3dpractical/fcoDetector/IMG_0498.JPG

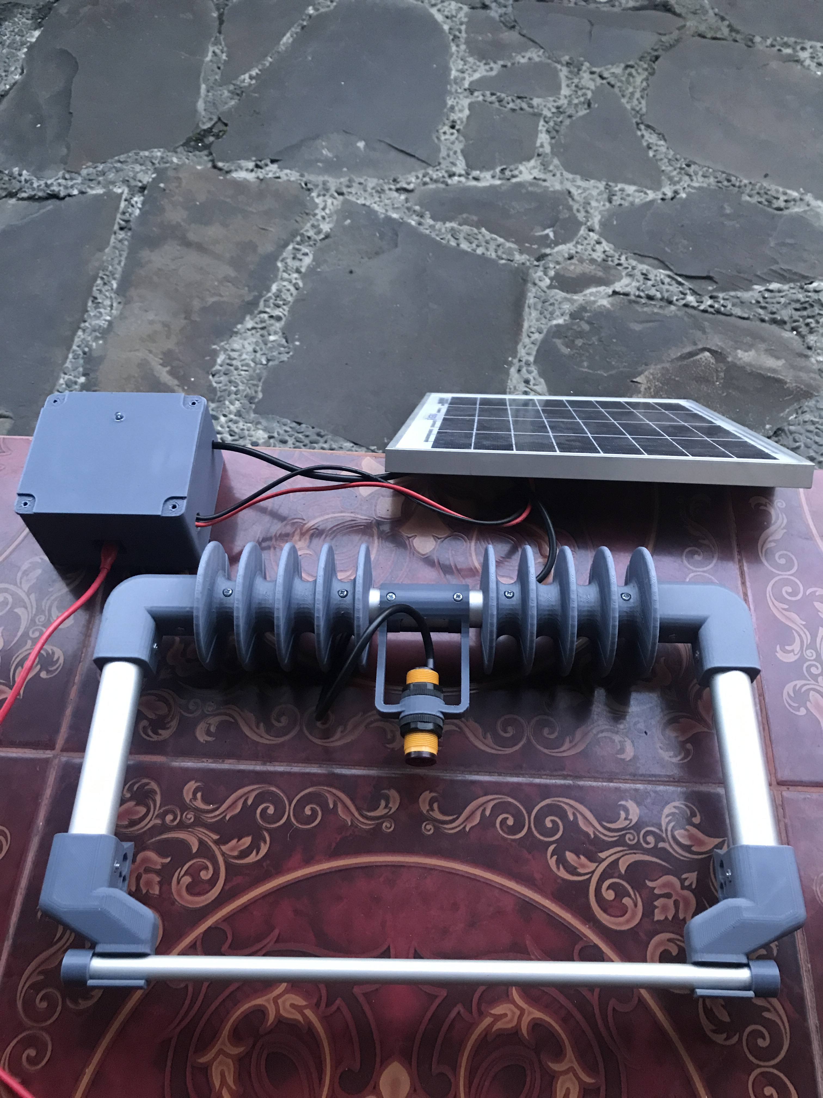
IMG_0498.JPG
