3dpractical/fcoDetector/Electrical Design/FCO_Detector R1/FCO_Detector/board.png

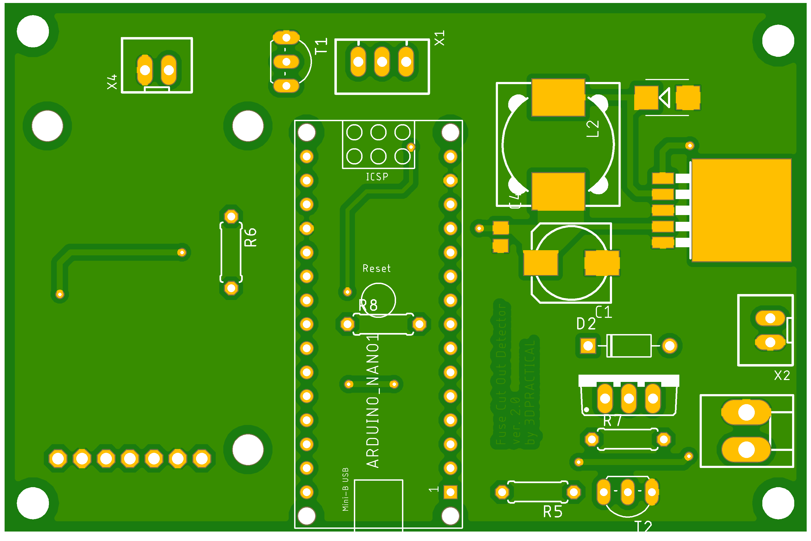
Electrical Design/FCO_Detector R1/FCO_Detector/board.png
