3dpractical/fcoDetector/FCO - Schematic.png

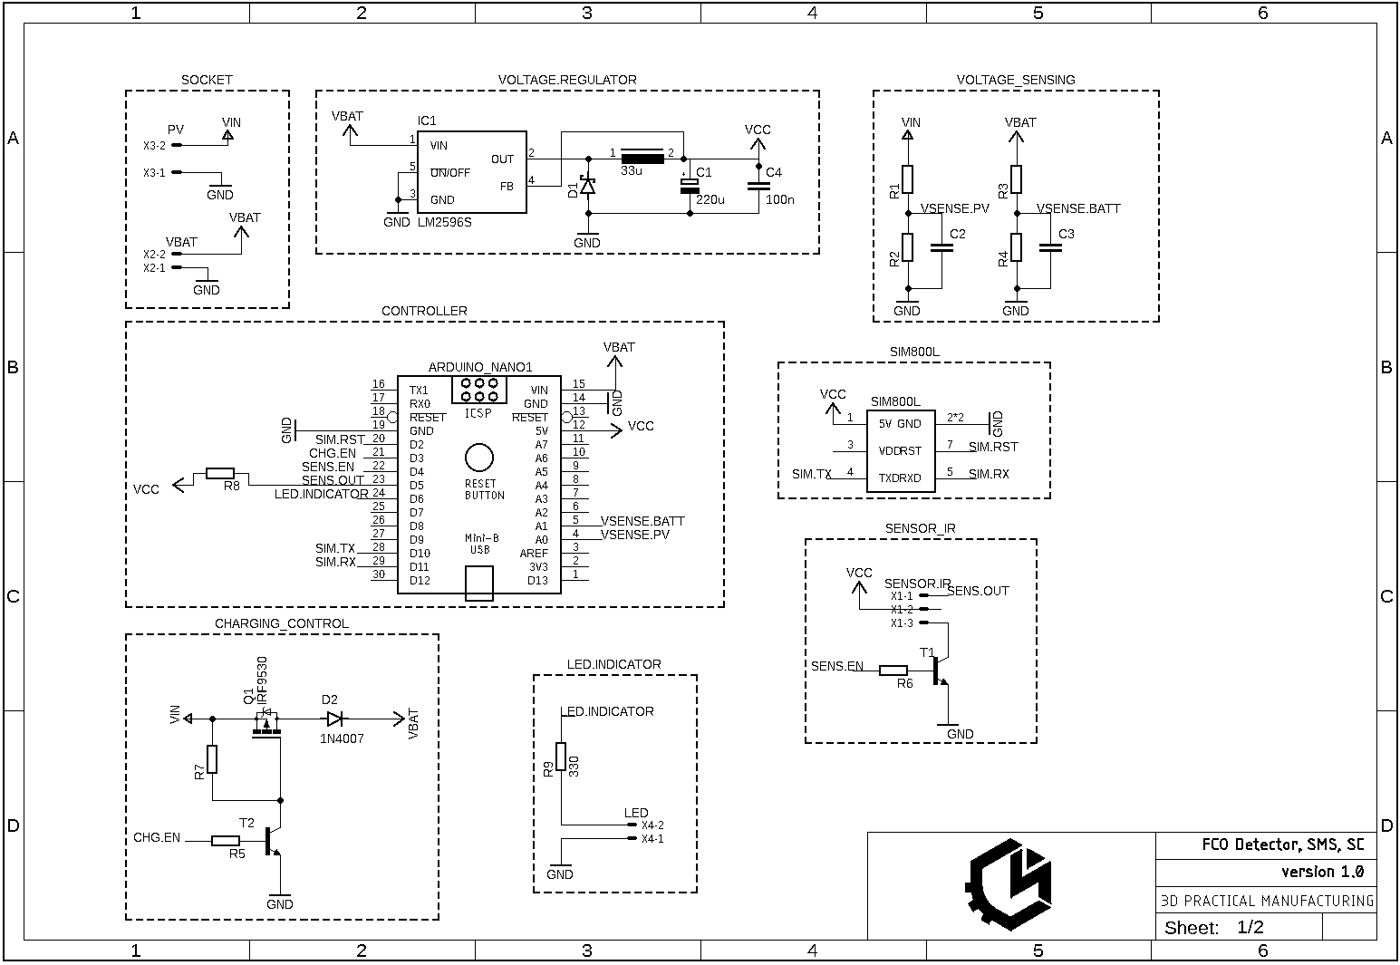
FCO - Schematic.png
