3dpractical/fcoDetector/Schematic Diagram.png

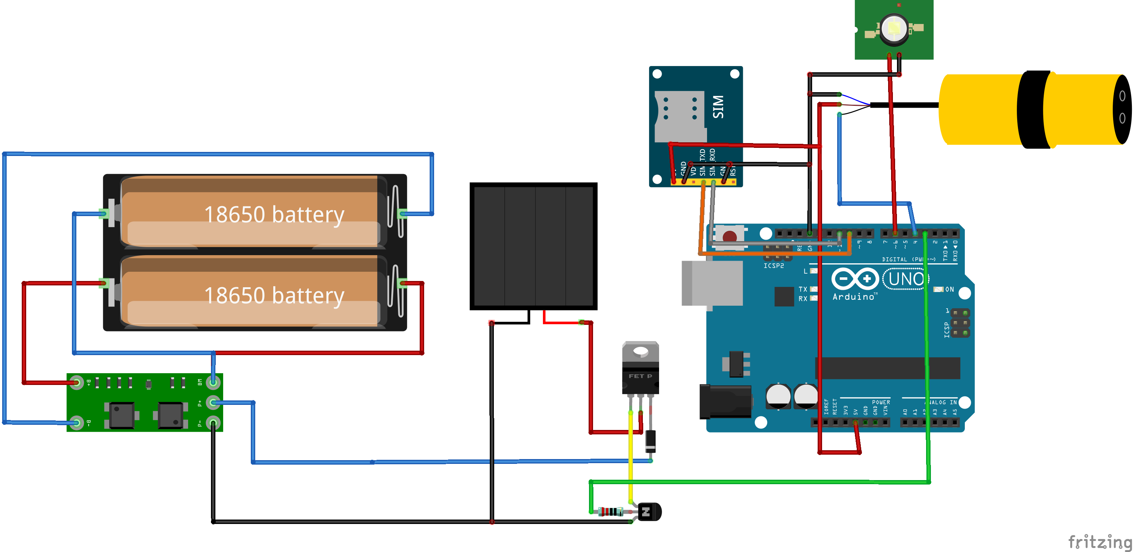
Schematic Diagram.png
