3dpractical/fcoDetector/Single Line Diagram/PWM SCC - FCO DETECTOR.jpg

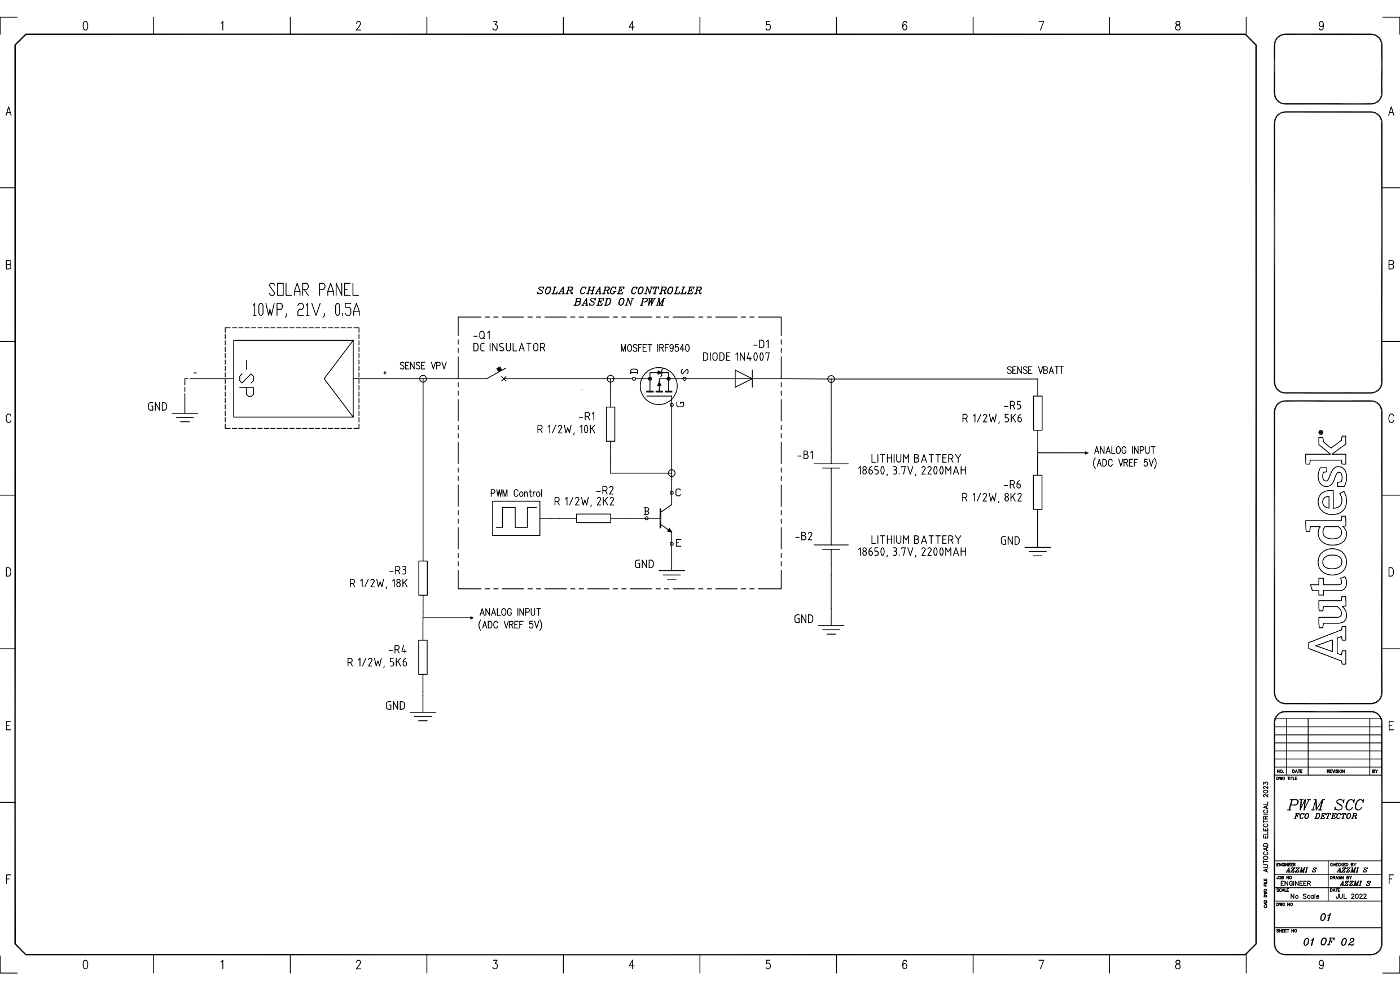
Single Line Diagram/PWM SCC - FCO DETECTOR.jpg
