3dpractical/fcoDetector/Mechanical Design/[3D Sketch] FCO detector/Assembly FCO Detector.SLDASM

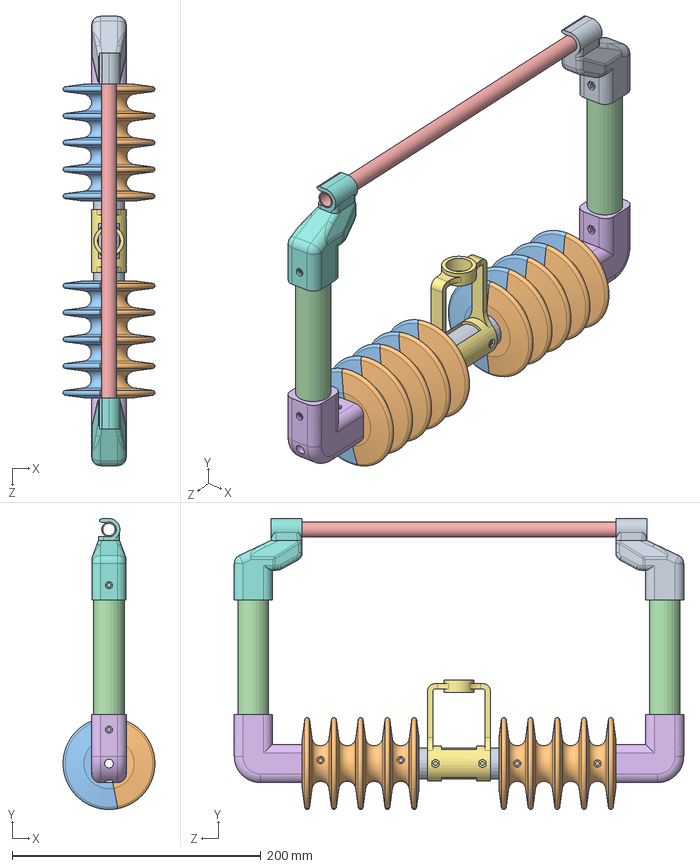
[picture p8: CAD file, 2022-10-04]
Mechanical Design/[3D Sketch] FCO detector/Assembly FCO Detector.SLDASM
73.8 x 233.8 x 361.2 mm
frame isolator
isolator atas x 2
isolator bawah x 2
frame sambungam x 2
fuse
terminal x 2
mount sensor
terminal fuse atas 2
terminal fuse atas
