3dpractical/fcoDetector/Mechanical Design/[3D Sketch] FCO detector/frame sambungam.SLDPRT

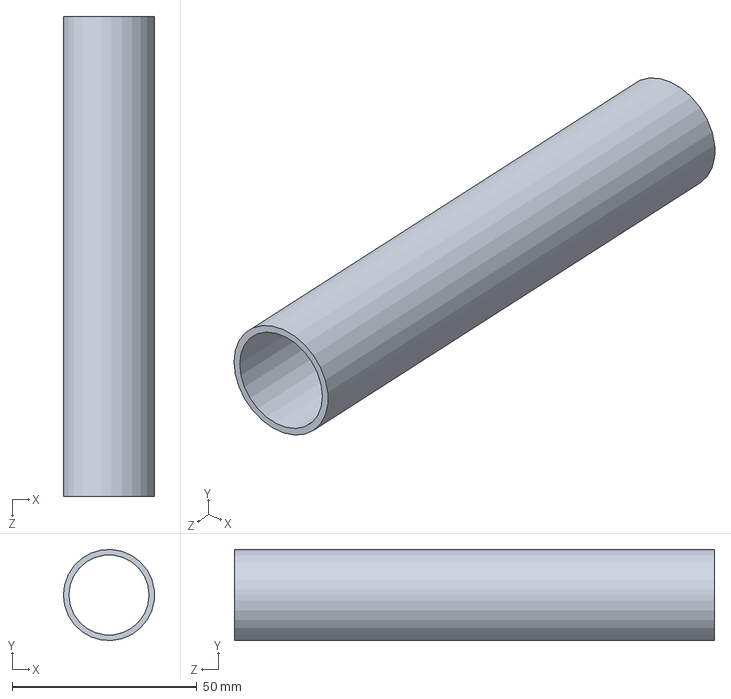
[picture p9: CAD file, 2022-10-04]
Mechanical Design/[3D Sketch] FCO detector/frame sambungam.SLDPRT
24.7 x 24.7 x 130.0 mm
