3dpractical/fcoDetector/Mechanical Design/[3D Sketch] FCO detector/trial.STEP

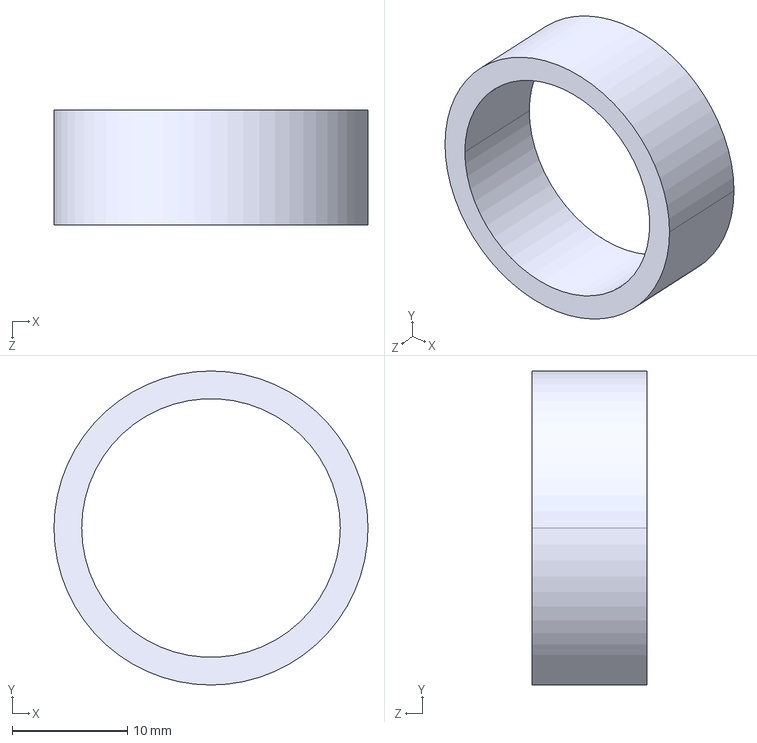
[picture p10: CAD file, 2022-10-04]
Mechanical Design/[3D Sketch] FCO detector/trial.STEP
27.2 x 27.2 x 10.0 mm
