3dpractical/fcoDetector/Mechanical Design/[3D Sketch] FCO detector/trial kc.SLDPRT

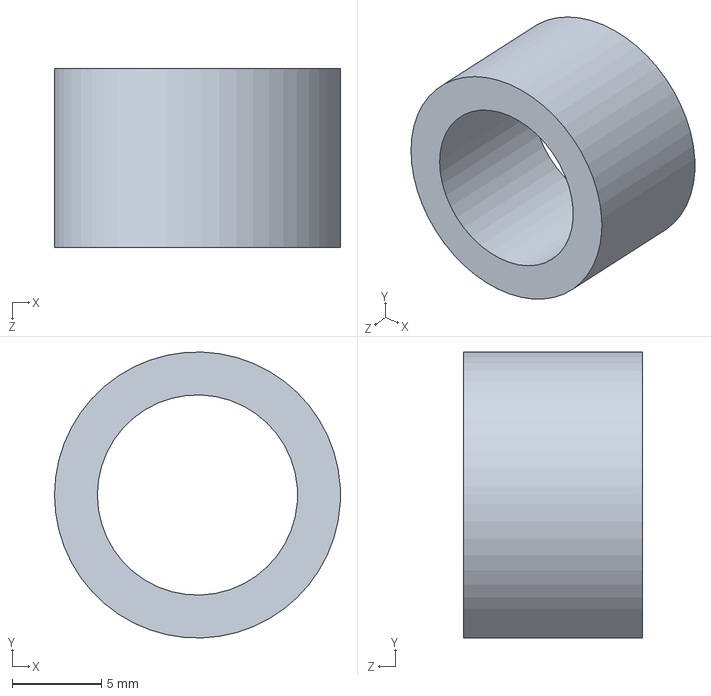
[picture p11: CAD file, 2022-10-04]
Mechanical Design/[3D Sketch] FCO detector/trial kc.SLDPRT
16.0 x 16.0 x 10.0 mm
