3dpractical/fcoDetector/Mechanical Design/[3D Sketch] FCO detector/isolator atas.SLDPRT

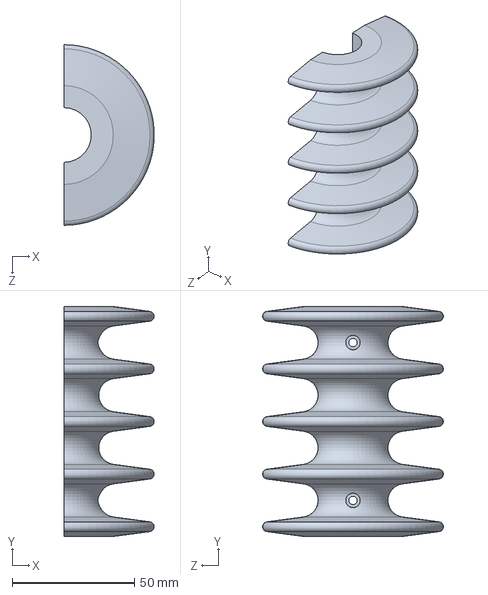
[picture p12: CAD file, 2022-10-04]
Mechanical Design/[3D Sketch] FCO detector/isolator atas.SLDPRT
36.9 x 94.0 x 73.9 mm
