3dpractical/fcoDetector/Mechanical Design/[3D Sketch] FCO detector/terminal fuse 2.SLDPRT

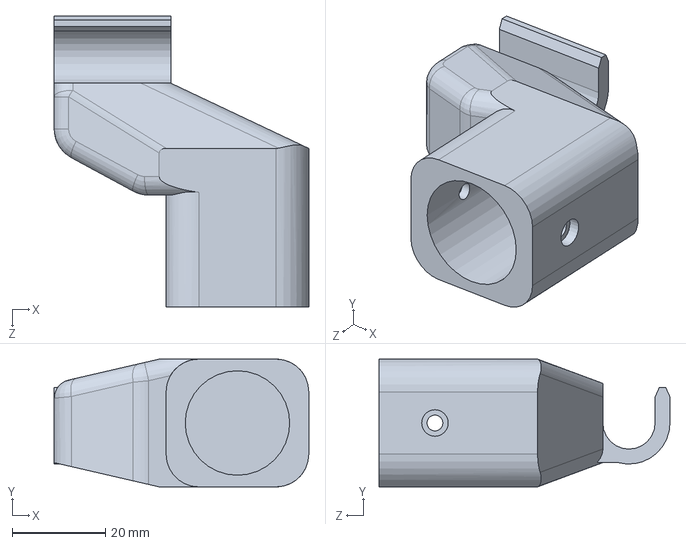
[picture p13: CAD file, 2022-10-04]
Mechanical Design/[3D Sketch] FCO detector/terminal fuse 2.SLDPRT
54.6 x 27.4 x 62.4 mm
