3dpractical/fcoDetector/Mechanical Design/[3D Sketch] FCO detector/tutup fuse.SLDPRT

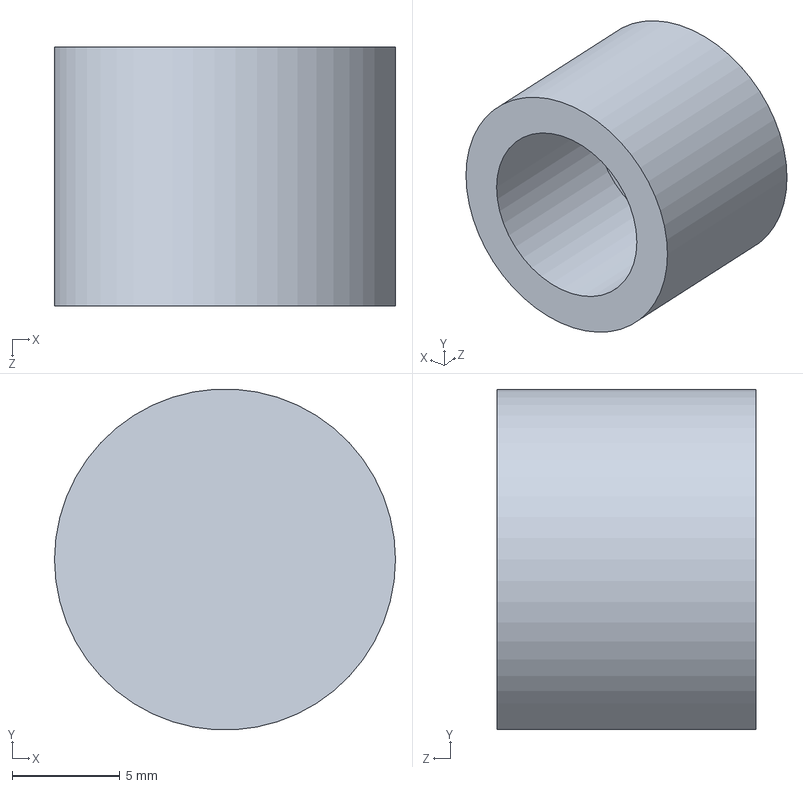
[picture p14: CAD file, 2022-10-04]
Mechanical Design/[3D Sketch] FCO detector/tutup fuse.SLDPRT
15.8 x 15.8 x 12.0 mm
