3dpractical/fcoDetector/Mechanical Design/[3D Sketch] FCO detector/terminal fuse atas.SLDPRT

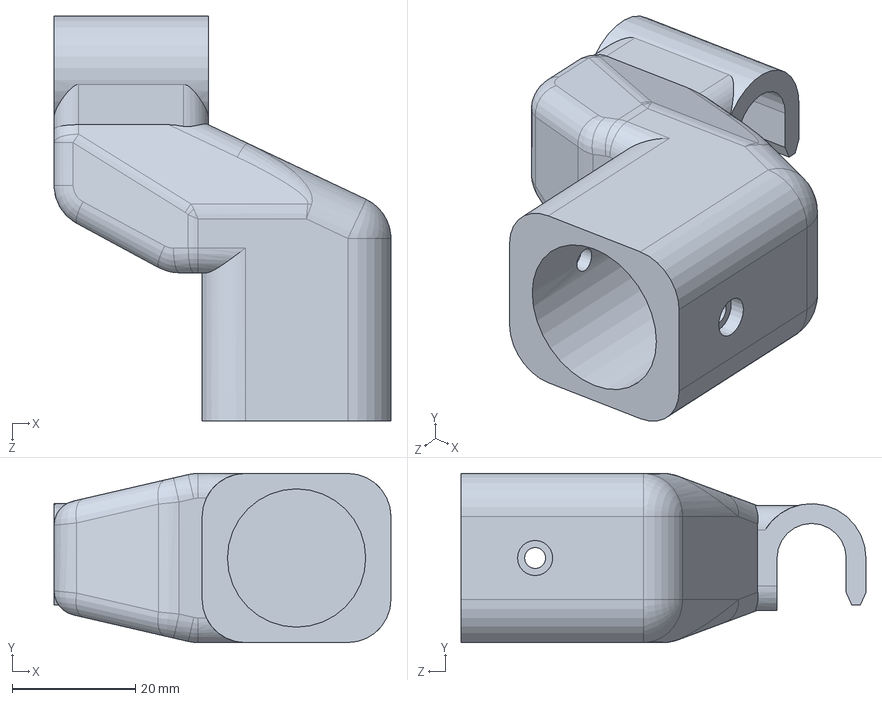
[picture p15: CAD file, 2022-10-04]
Mechanical Design/[3D Sketch] FCO detector/terminal fuse atas.SLDPRT
54.6 x 27.4 x 65.6 mm
