3dpractical/fcoDetector/Mechanical Design/[3D Sketch] FCO detector/frame isolator.SLDPRT

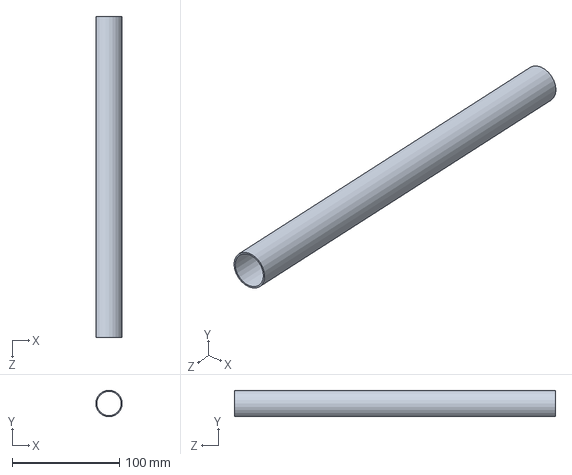
[picture p16: CAD file, 2022-10-04]
Mechanical Design/[3D Sketch] FCO detector/frame isolator.SLDPRT
24.7 x 24.7 x 300.0 mm
