3dpractical/fcoDetector/Mechanical Design/[3D Sketch] FCO detector/terminal.SLDPRT

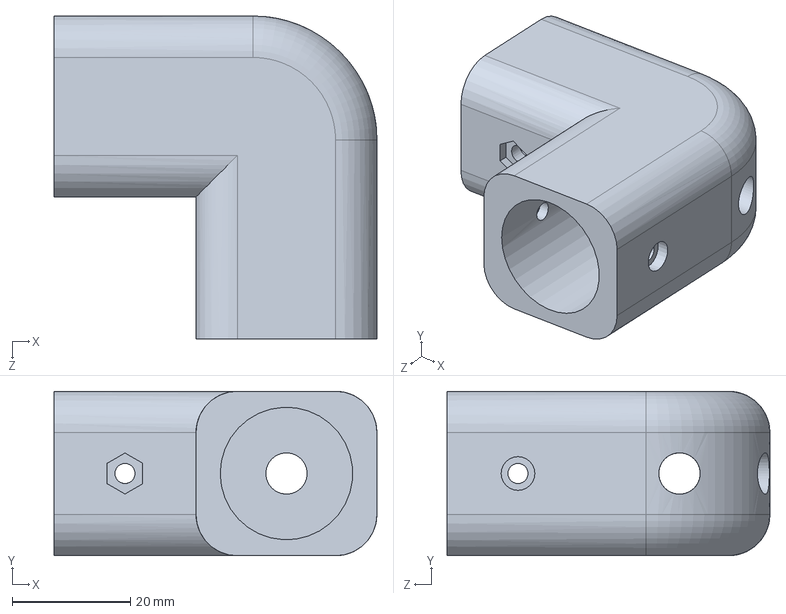
[picture p17: CAD file, 2022-10-04]
Mechanical Design/[3D Sketch] FCO detector/terminal.SLDPRT
54.6 x 27.8 x 54.6 mm
