3dpractical/fcoDetector/Mechanical Design/[3D Sketch] FCO detector/fuse.SLDPRT

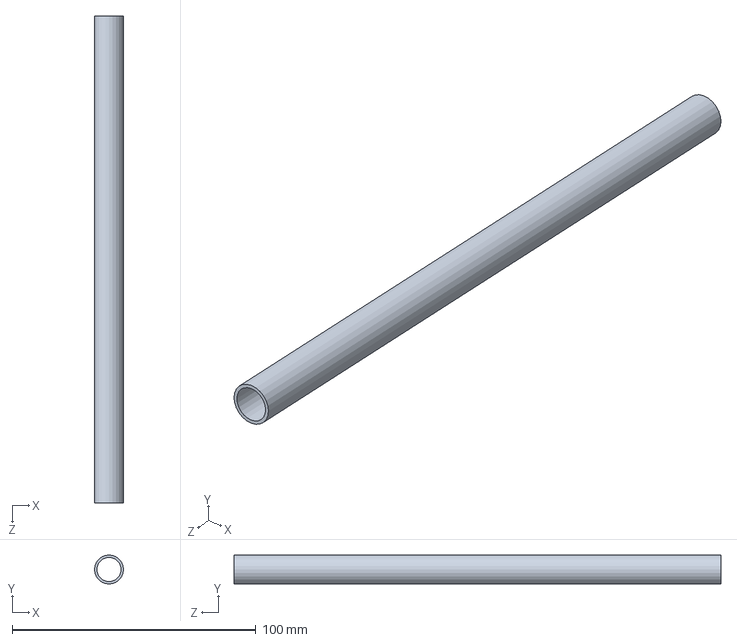
[picture p18: CAD file, 2022-10-04]
Mechanical Design/[3D Sketch] FCO detector/fuse.SLDPRT
11.9 x 11.9 x 200.0 mm
