3dpractical/fcoDetector/Mechanical Design/[3D Sketch] FCO detector/mount sensor.SLDPRT

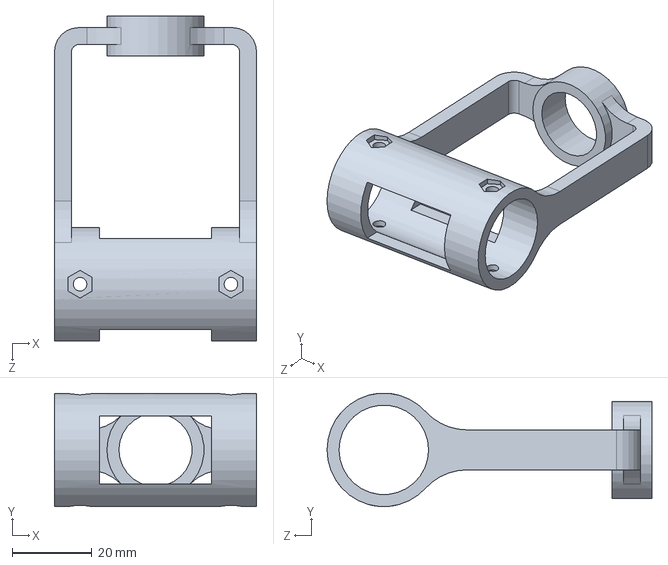
[picture p19: CAD file, 2022-10-04]
Mechanical Design/[3D Sketch] FCO detector/mount sensor.SLDPRT
50.5 x 28.3 x 81.3 mm
