3dpractical/fcoDetector/Mechanical Design/[3D Sketch] FCO detector/terminal fuse.SLDPRT

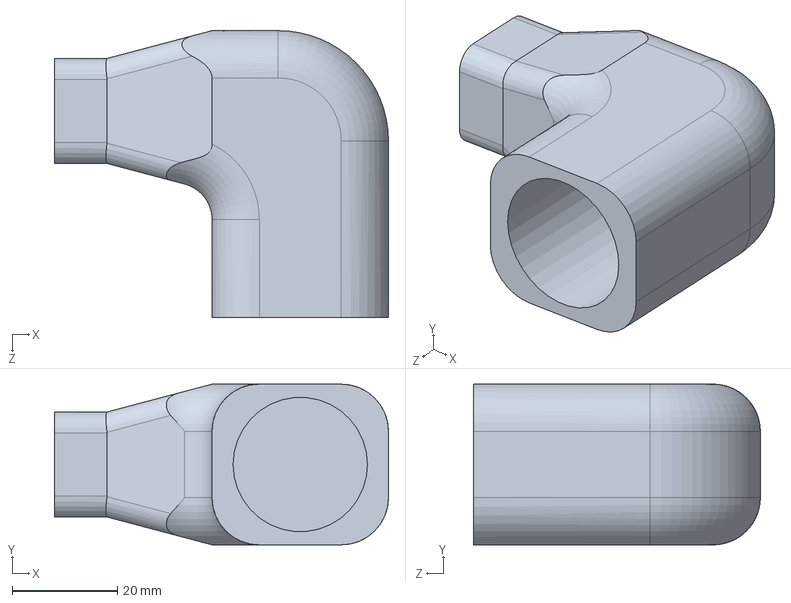
[picture p20: CAD file, 2022-10-04]
Mechanical Design/[3D Sketch] FCO detector/terminal fuse.SLDPRT
63.6 x 30.6 x 54.6 mm
