3dpractical/fcoDetector/Mechanical Design/[3D Sketch] FCO detector/isolator.STL

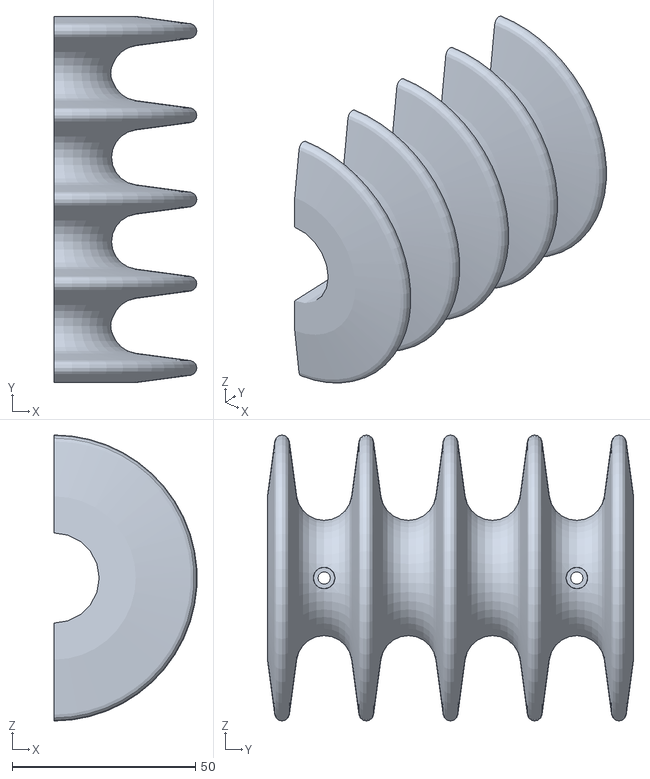
[picture p21: CAD file, 2022-10-04]
Mechanical Design/[3D Sketch] FCO detector/isolator.STL
39.0 x 100.0 x 78.1
