3dpractical/fcoDetector/(list of files, cad)

Other CAD files:
Mechanical Design/[3D Sketch] FCO detector/isolator bawah.SLDPRT
Mechanical Design/[3D Sketch] FCO detector/terminal fuse atas 2.SLDPRT
Mechanical Design/[3D Sketch] FCO detector/isolator atas.STL
Mechanical Design/[3D Sketch] FCO detector/isolator bawah.STL
Mechanical Design/[3D Sketch] FCO detector/mount sensor.STL
Mechanical Design/[3D Sketch] FCO detector/terminal fuse 2.STL
Mechanical Design/[3D Sketch] FCO detector/terminal fuse atas 2.STL
Mechanical Design/[3D Sketch] FCO detector/terminal fuse atas.STL
Mechanical Design/[3D Sketch] FCO detector/terminal.STL
Mechanical Design/[3D Sketch] FCO detector/trial kc.STL
Mechanical Design/[3D Sketch] FCO detector/trial.SLDPRT
Mechanical Design/[3D Sketch] FCO detector/trial.STL
Mechanical Design/[3D Sketch] FCO detector/tutup fuse.STL
