3dpractical/fcoDetector/Electrical Design/FCO_Detector R1/FCO_ESP32/main.brd

## EAGLE design Electrical Design/FCO_Detector R1/FCO_ESP32/main.brd (2022-10-04)

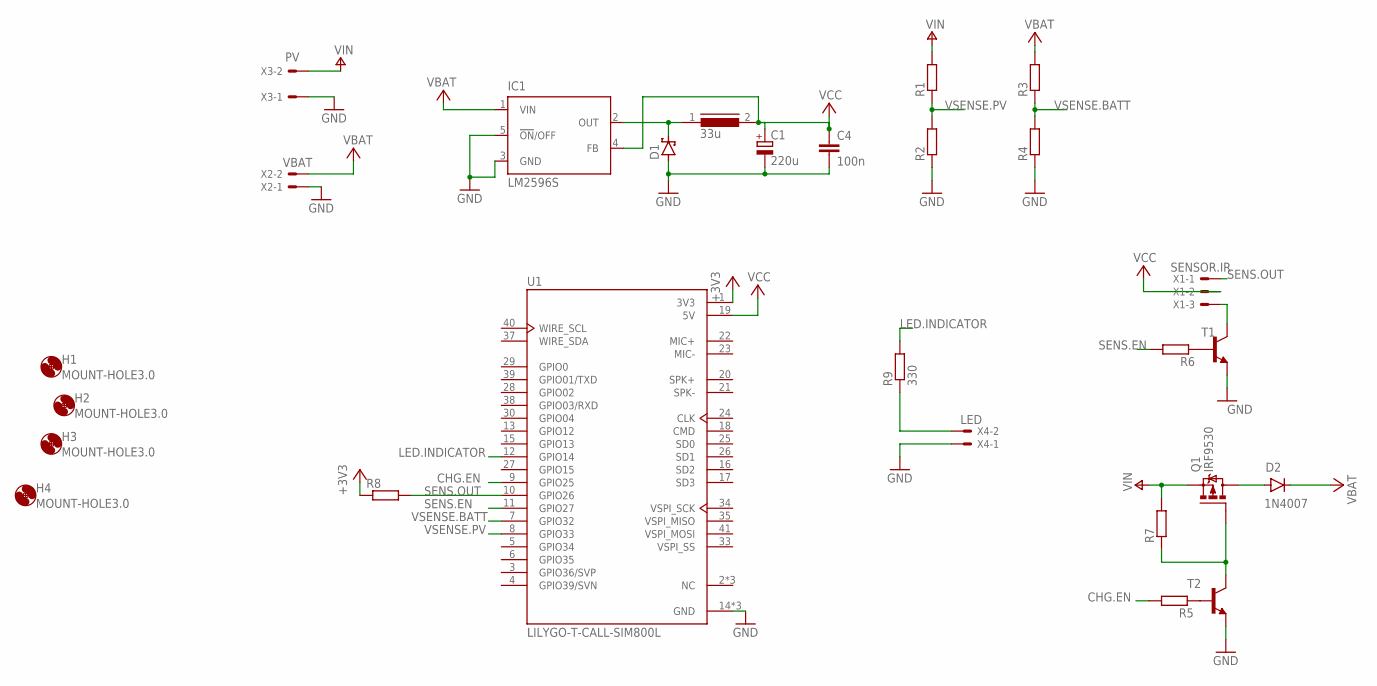
[picture p22: schematic main.sch]

Parts:
C1: 220u; 153CLV-0810
C4: 100n; C0805
D1: SCHOTTKY-DIODESMD; SMB
D2: 1N4007; DO-41
H1, H2, H3, H4: MOUNT-HOLE3.0; 3,0
IC1: LM2596S; TO263-5
L2: 33u; DR125
Q1: IRF9530; TO220BV
R1, R2, R3, R4, R8: R-EU_R0805; R0805
R5, R6, R7: R-EU_0207/7; 0207/7
R9: 330; R0805
T1, T2: -NPN-TO92-ECB; TO92-ECB
U1: LILYGO-T-CALL-SIM800L; XCVR_LILYGO-T-CALL-SIM800L
X1: SENSOR.IR; JST-XH-03-PACKAGE-LONG-PAD
X2: VBAT; JST-XH-02-PACKAGE-LONG-PAD
X3: PV; KK-156-2
X4: LED; JST-XH-02-PACKAGE-LONG-PAD

Connections:
+3V3: R8.1, U1.1 (3V3)
+5V: D2.C, IC1.1 (VIN), R3.2, X2.2
CHG.EN: R5.2, U1.9 (GPIO25)
GND: C1.-, C4.2, D1.A, IC1.3 (GND), IC1.5 (!ON!/OFF), R2.1, R4.1, T1.E, T2.E, U1.14 (GND), U1.36 (GND), U1.42 (GND), X2.1, X3.1, X4.1
LED.INDICATOR: R9.2, U1.12 (GPIO14)
MIC+: U1.22 (MIC+)
MIC-: U1.23 (MIC-)
unnamed: T1.C, X1.3
unnamed: R6.1, T1.B
unnamed: R9.1, X4.2
unnamed: D1.C, IC1.2 (OUT), L2.1
unnamed: Q1.G, R7.1, T2.C
unnamed: D2.A, Q1.D
unnamed: R5.1, T2.B
NC: U1.2 (NC), U1.31 (NC), U1.32 (NC)
SENS.EN: R6.2, U1.11 (GPIO27)
SENS.OUT: R8.2, U1.10 (GPIO26), X1.1
SPK+: U1.20 (SPK+)
SPK-: U1.21 (SPK-)
V+: Q1.S, R1.2, R7.2, X3.2
VCC: C1.+, C4.1, IC1.4 (FB), L2.2, U1.19 (5V), X1.2
VSENSE.BATT: R3.1, R4.2, U1.7 (GPIO32)
VSENSE.PV: R1.1, R2.2, U1.8 (GPIO33)

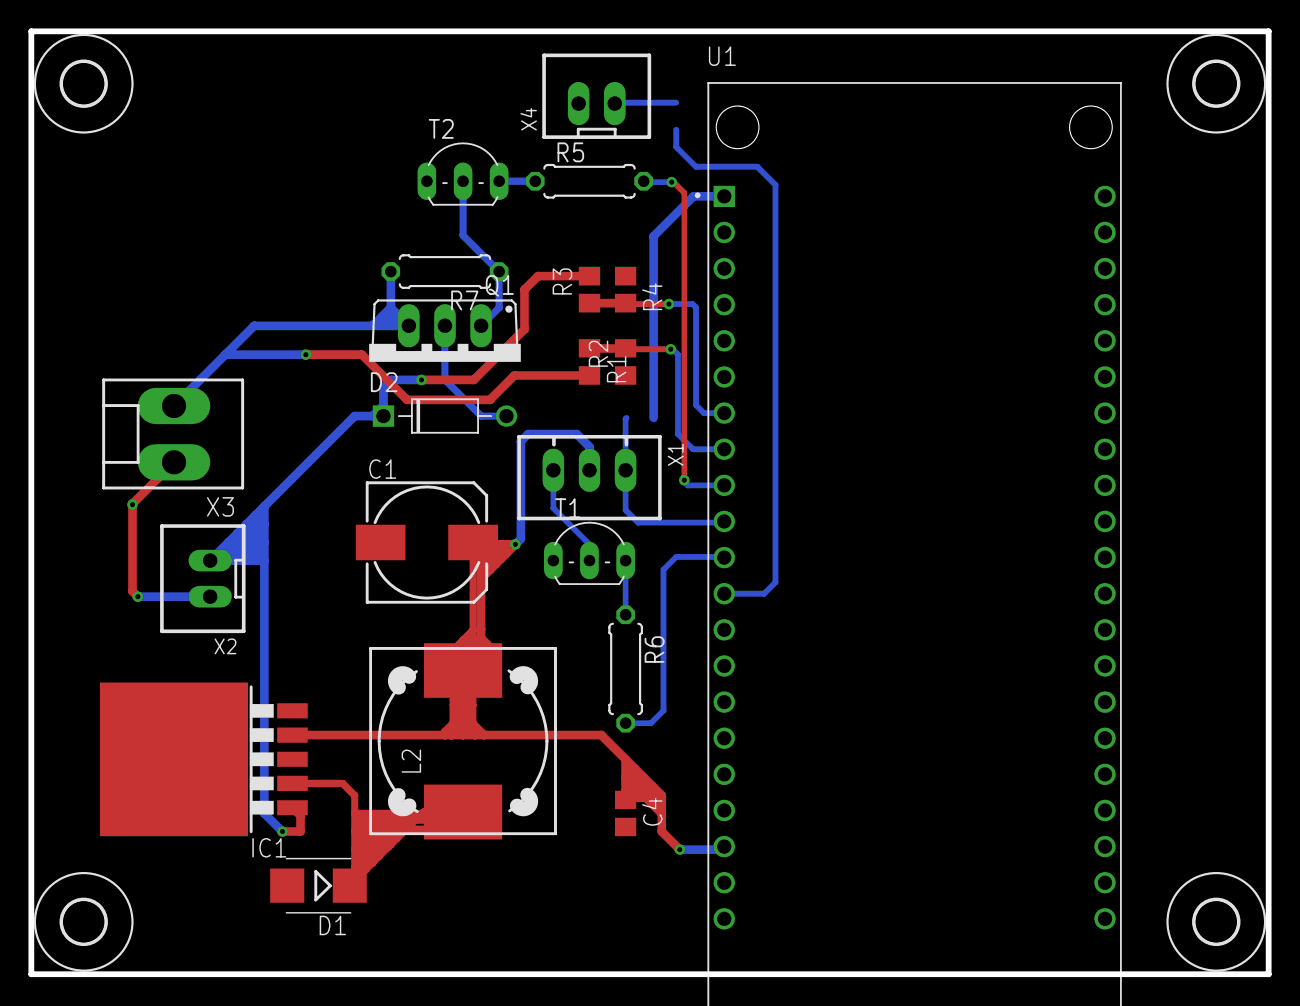
[picture p23: board main.brd from above]

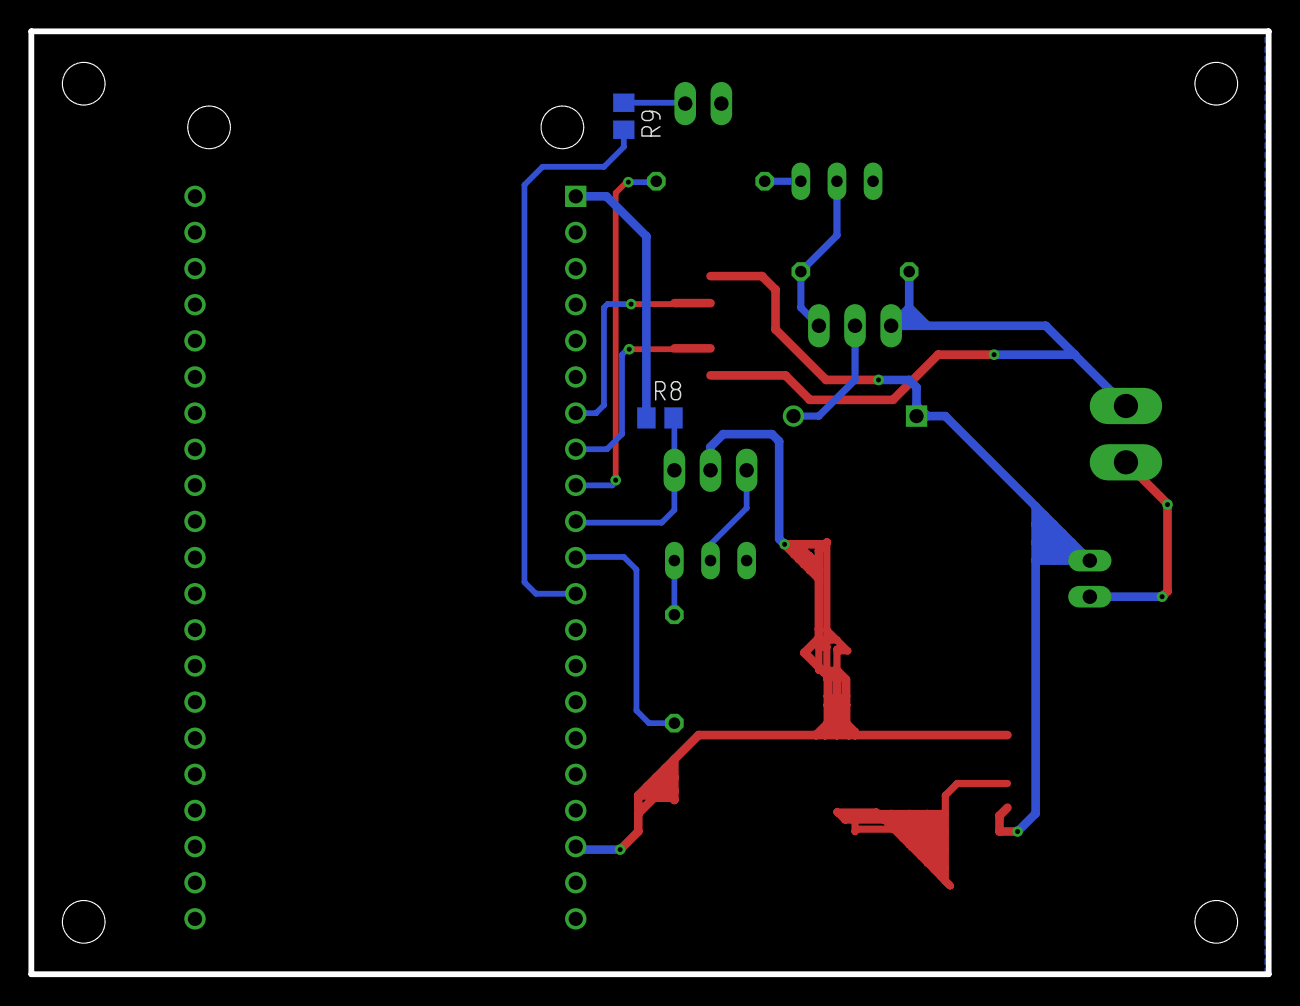
[picture p24: board main.brd from below]

Board: 2 copper layers, 87.0 x 66.3 mm, 27 parts (2 on the bottom side), 19 nets.
