3dpractical/fcoDetector/IMG_0495.JPG

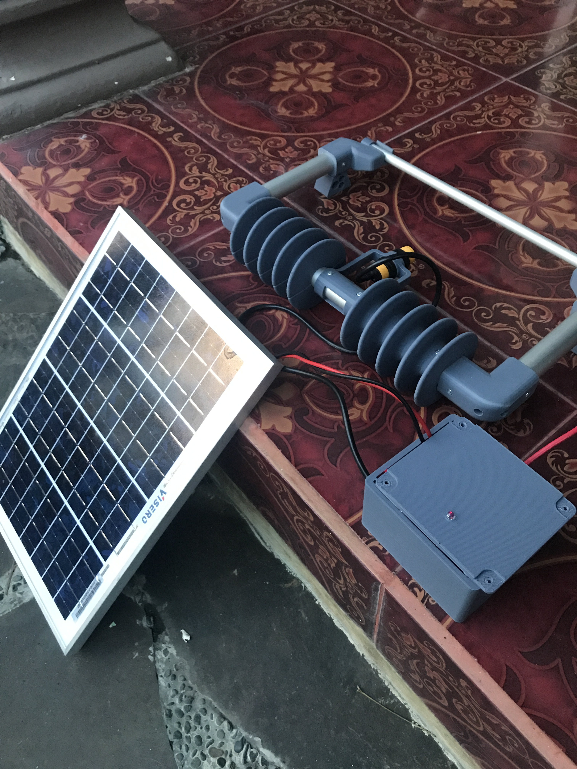
IMG_0495.JPG
