3dpractical/fcoDetector/IMG_0499.JPG

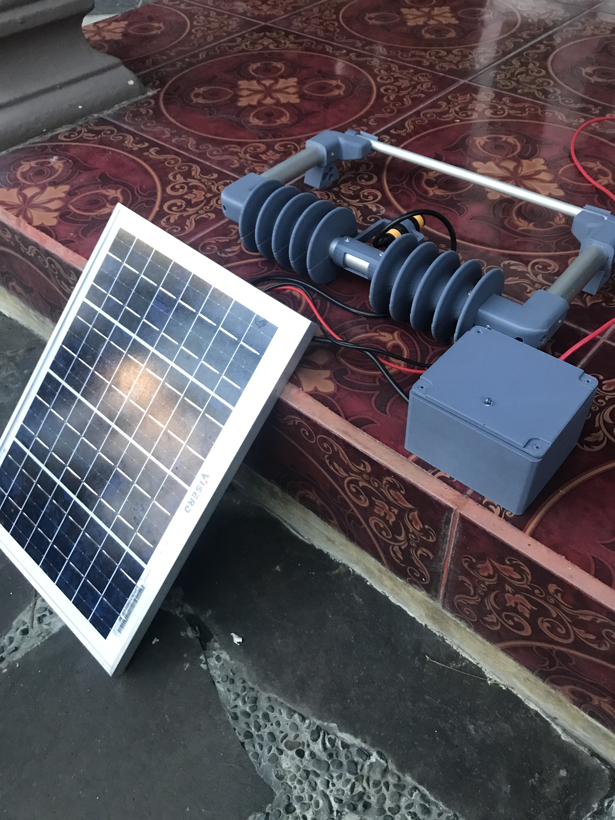
IMG_0499.JPG
